OlegRubtsov/Auto-Start-Engine/README.md

Автозапуск авто на arduino и модеме m590e
запуск возможен двойным звонком на номер сим карты, оба звонка должны быть сделаны на 30 секунд
если двигатель запущен, то одиночный звонок продлит время работы
All commands:  - перечень СМС
Start          - запуск
Stop           - остановка
Balance        - баланс встроенной сим карты
Info           - краткая информация о системе (статус, напряжение, температура...)
List           - перечень прописанных телефонов
P0 79001122331 - установка прописанных номеров, максимум 3 штуки, формат СМС "P0 7900xxxxxxx" или "P1 7900xxxxxxx" или "P2 7900xxxxxxx",
P1 79001122332 - в рамках безопасности это может сделать или уже авторизованный номер,  
P2 79001122333 - или при нажатом тормозе и выключенном двигателе (подразумевается что действие производит владелец изнутри авто) 
SmsON          - включение уведомления о запуске, остальное смысловое общение, естественно через СМС
SmsOFF         - выключение уведомления о запуске
Factory        - сброс на типовые настройки (FactoryReset)
Time 0..30     - время прогрева от 1 до 30 минут, 0 - автоматический режим
STms 0..3000   - время прокрутки стартера (в микросекундах) от 1 до 3000 микросекунд, 0 - автоматический режим
Help           - перечень команд
