OlegRubtsov/Auto-Start-Engine/info.txt

Автозапуск авто на arduino и модеме m590e

Устройство предназначено для запуска авто с автоматической коробкой передач
Команды на запуск авто с авторизованного телефона

Вариант 1: СМС команда Start

Вариант 2: 2 звонка на номер с перерывом не более 30 секунд

Установить (прописать) авторизованный номер можно отправив СМС формата "P0 79001112233", в рамках безопасности это может сделать или уже авторизованный номер, или при нажатом тормозе и выключенном двигателе

Все СМС команды
