OlegRubtsov/Auto-Start-Engine/Основная_плата_2020-05-05-2.GIF

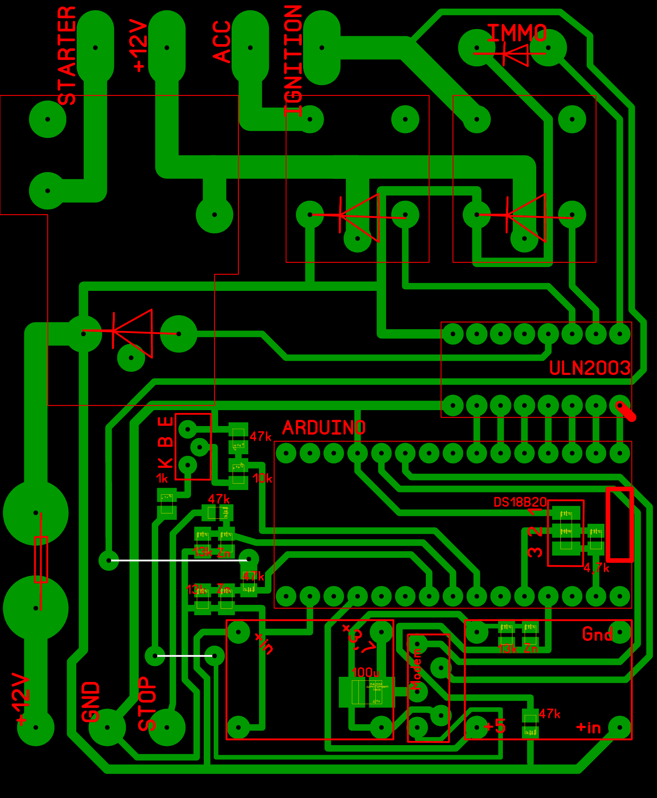
Основная_плата_2020-05-05-2.GIF
