OlegRubtsov/Auto-Start-Engine/схема.jpg

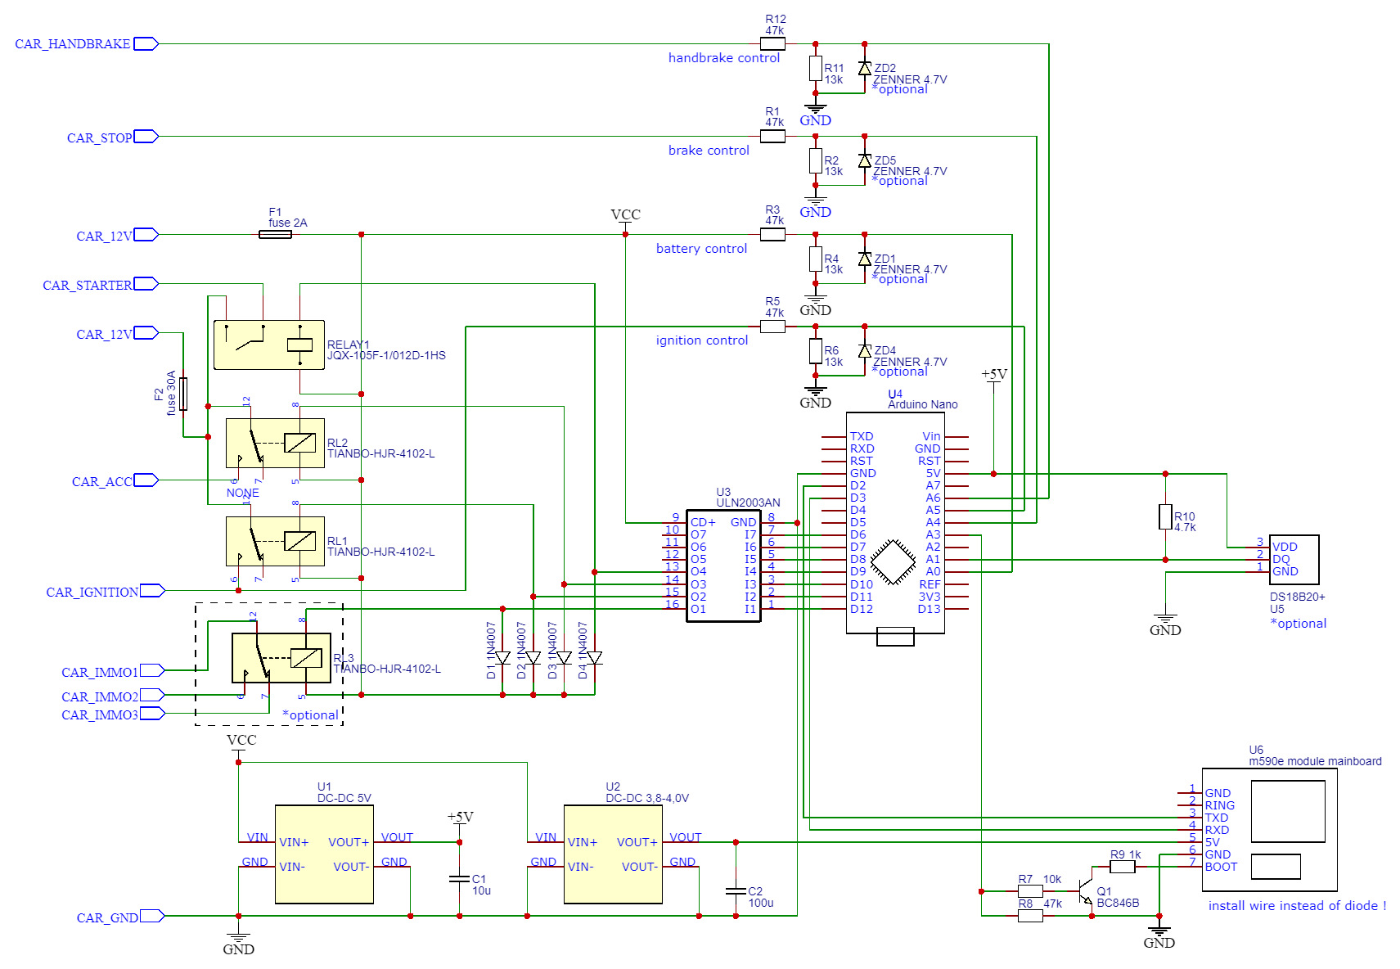
схема.jpg
