OlegRubtsov/Auto-Start-Engine/details.xlsx

№ | Наименование | Цена | Кол-во | Ед.изм. | Сумма | 762
1 | Arduino nano 3.0 | 130 | 1 | шт. | 130 | https://ru.aliexpress.com/item/32231549015.html
2 | M590E GSM GPRS модуль | 85 | 1 | шт. | 85 | https://ru.aliexpress.com/item/4000310474883.html?spm=a2g0o.placeorder.0.0.16f729fd1yCWgi&mp=1
3 | Mini 360 DC-DC/DC понижающий преобразователь | 23 | 2 | шт. | 46 | https://ru.aliexpress.com/item/32899671137.html?scm-url=1007.13338.146109.0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
4 | ULN2003 | 52 | 1 | шт. | 52 | https://ru.aliexpress.com/item/32907420918.html
5 | водонепроницаемый 18B20 датчик температуры | 73 | 1 | шт. | 73 | https://ru.aliexpress.com/item/32832225749.html?spm=a2g0o.placeorder.0.0.233529fdWQPZIt&mp=1
6 | автореле 12в 20А с разъемом | 80 | 3 | шт. | 240 | автомагазин
7 | автореле 12в 30А с разъемом | 80 | 1 | шт. | 80 | автомагазин
8 | предохранитель 2А | 10 | 1 | шт. | 10 | автомагазин
9 | предохранитель 30А | 10 | 1 | шт. | 10 | автомагазин
10 | диод 100 шт. 1N4007 | 36 | 1 | шт. | 36 | https://ru.aliexpress.com/item/32843733405.html?s=p
11 | резисторы
12 | плата
13 | провода
14 | разъемы
