OlegRubtsov/Auto-Start-Engine/(list of files, drawings)

Other design files:
Основная_плата_2020-05-05-2.lay6
